Aleksei327/STM32G474-Precision-Lab-Power-Supply/hardware/jumper-wires.txt

WIRE JUMPERS - assembly list (single-sided board, top side)
Board POWER_0-50, 25 jumpers, total wire length ~1330 mm. Coordinates are KiCad board coordinates (mm).

N   NET          FROM (x,y) mm      TO (x,y) mm        LENGTH
------------------------------------------------------------------------
1   DVIN         ( 101.5, 103.2)   ( 189.0,  56.5)    99.2 mm
2   EN_LIN       ( 170.5, 122.2)   ( 174.5, 122.2)     4.1 mm
3   GND          ( 220.5,  90.2)   ( 193.5,  89.7)    27.0 mm
4   GND          ( 220.5, 146.2)   ( 194.5, 150.2)    26.3 mm
5   GND          (  88.0,  79.2)   (  67.9,  79.9)    20.2 mm
6   GND          ( 131.6, 120.3)   ( 118.9, 120.3)    12.8 mm
7   GND          (  66.2, 140.4)   (  55.5, 140.6)    10.7 mm
8   GND          ( 111.7,  54.1)   ( 113.7,  64.4)    10.5 mm
9   GND          ( 138.0,  90.2)   ( 135.5,  81.7)     8.9 mm
10  GND          ( 104.4,  82.7)   ( 104.5,  90.2)     7.5 mm
11  GND          (  92.5, 110.9)   (  97.5, 112.2)     5.1 mm
12  GND          (  92.5, 117.2)   (  92.5, 119.8)     2.5 mm
13  GND          ( 183.0, 131.2)   ( 185.5, 131.0)     2.5 mm
14  HI           ( 160.1,  99.2)   ( 161.1, 101.7)     2.6 mm
15  OUT_MINUS    ( 192.5, 131.0)   ( 107.0,  79.2)    99.9 mm
16  OUT_MINUS    ( 192.5, 131.0)   ( 244.5,  69.7)    80.4 mm
17  RELAY_DRV    ( 136.0,  88.2)   ( 242.3, 104.2)   107.5 mm
18  REV_DET      ( 119.0, 105.2)   ( 249.5,  46.1)   143.2 mm
19  V12          (  91.0,  54.6)   (  56.1,  68.5)    37.6 mm
20  VDS0         ( 100.0,  94.6)   ( 224.5,  65.2)   127.9 mm
21  VIN_55       ( 184.0,  84.2)   (  64.2, 152.7)   137.9 mm
22  VS0          ( 237.0,  85.2)   ( 105.5,  73.2)   132.0 mm
23  VT0          ( 252.5,  62.1)   ( 104.5, 105.7)   154.2 mm
24  V_N5         (  66.5,  39.7)   (  89.0,  49.6)    24.6 mm
25  V_P67        (  91.0,  57.2)   (  47.5,  47.0)    44.7 mm

By net: GND=11, OUT_MINUS=2, DVIN=1, EN_LIN=1, HI=1, RELAY_DRV=1, REV_DET=1, V12=1, VDS0=1, VIN_55=1, VS0=1, VT0=1, V_N5=1, V_P67=1
