Aleksei327/STM32G474-Precision-Lab-Power-Supply/docs/architecture.ru.md

# Архитектура системы

[English version](architecture.md) · [Обзор проекта](../README.ru.md) · [Полная схема](images/lab-psu-schematic-ru.svg)

## Назначение

Блок питания рассчитан на программируемый выход 0–50 В с пользовательским шагом 1 мВ и 1 мА и целевыми пульсациями не более 1 мВ. Высокий КПД и низкий шум совмещены разделением регулирования между импульсным предрегулятором и быстрым аналоговым пострегулятором.

Эти значения являются проектными целями. Аппаратура собрана и находится в наладке (ноябрь 2026); испытания под нагрузкой, тепловые испытания, коррекция петель и итоговая электрическая проверка ещё выполняются.

## Силовой тракт

```mermaid
flowchart LR
    A[Сеть 230 В] --> B[Активный PFC<br/>около 380 В DC]
    B --> C[Двухключевой forward<br/>гальваническая развязка]
    C --> D[Выпрямитель и фильтр<br/>около 55 В]
    D --> E[Синхронный buck<br/>трекинговый предрегулятор]
    E --> F[Демпфированный C-L-C-фильтр]
    F --> G[OPA454 + проходной MOSFET<br/>линейный пострегулятор]
    G --> H[Защиты и реле]
    H --> I[Выход 0-50 В]
```

### Изолированный сетевой преобразователь

Горячая часть использует силовые узлы доработанного ATX-блока NEO500 мощностью 500 Вт:

- активный PFC на CM6800TX и шина около 380 В;
- двухключевой прямоходовый преобразователь с первичными MOSFET 18N50;
- трансформатор управления затворами для синхронного верхнего и нижнего ключей;
- трансформаторная развязка сетевой части от выхода и управления;
- быстрый вторичный выпрямитель STTH30R03 и фильтр на 100 В.

Установленный трансформатор имеет вторичную обмотку 22 витка из четырёх параллельных проводов диаметром 0,6 мм. Для неё принят режим около 5–6 А длительно и 8 А кратковременно. Силовая часть рассчитана на последующую модернизацию трансформатора до 10 А.

### Трекинговый синхронный buck

Синхронный buck построен на двух IRFB4110 и драйвере UCC27211. Комплементарный ШИМ формирует HRTIM микроконтроллера STM32G474. Быстрые каналы АЦП измеряют напряжения на стоке и истоке линейного проходного MOSFET, а прошивка поддерживает на нём запас около 2–2,5 В.

Так основная мощность регулируется эффективным импульсным каскадом, а линейному каскаду остаётся достаточное напряжение для подавления пульсаций и переходных процессов.

Выход buck содержит:

- 1000 мкФ / 100 В и локальные керамические конденсаторы 4,7 мкФ / 100 В;
- последовательный дроссель 2,2 мкГн не менее 12 А;
- два керамических конденсатора 4,7 мкФ / 100 В у стока линейного каскада;
- электролит 100 мкФ / 100 В, ESR которого демпфирует резонанс C–L–C.

Частота среза фильтра около 10 кГц; на частоте коммутации примерно 95–100 кГц он даёт дополнительное подавление.

### Линейный пострегулятор

OPA454 сравнивает уставку ЦАП с масштабированным выходным напряжением и управляет проходным IRFB4110 по схеме истокового повторителя. В базовой сборке устанавливается один MOSFET; на плате предусмотрены места для дополнительных параллельных приборов, если это потребуется по результатам тепловых испытаний.

Делитель обратной связи около 110 кОм / 5,1 кОм задаёт усиление примерно 22. Применяются согласованные резисторы 0,1% и 25 ppm/°C, а остаточные погрешности коэффициента и смещения устраняются калибровкой.

Отрицательная шина −5 В выводит OPA454 из области ограничения нижнего размаха. Активная преднагрузка около 6 мА, привязанная к этой шине, удерживает аналоговую петлю в регулируемом состоянии около нуля и обеспечивает управляемое снижение напряжения.

## Уставки и измерение

| Функция | Реализация |
| --- | --- |
| Уставка напряжения | DAC8830, 16 бит, 0–2,5 В от REF5025 |
| Расчётная дискретность выхода | `2,5 В / 65536 × 22 ≈ 0,84 мВ` |
| Напряжение клемм и ток | 20-битный INA228 |
| Шунт тока | константан около 10 мОм с кельвиновским подключением |
| Дискретность измерения тока | около 31 мкА/LSB с выбранным шунтом |
| Регулирование тока | цифровой CC, целевая частота обновления около 1–2 кГц |
| Быстрые каналы трекинга | АЦП STM32, синхронизированные с HRTIM |

INA228 непосредственно измеряет напряжение выходной шины и ток шунта и не зависит от опоры АЦП микроконтроллера. Реле измерительного входа подключает VBUS к реальным клеммам при включённом силовом реле. Медленная цифровая коррекция компенсирует падения на реле, предохранителе, дорожках и шунте, не перенося быструю аналоговую петлю напряжения через переключающийся контакт.

## Режимы управления

- стабилизация напряжения быстрой аналоговой петлёй;
- цифровая стабилизация тока по данным INA228;
- программируемый foldback тока в зависимости от выходного напряжения;
- управляемый подъём и снижение напряжения;
- включение выхода после предварительных проверок;
- температурное снижение тока и отключение.

STM32G474 также обслуживает SPI-дисплей 480×320, раздельные энкодеры напряжения и тока, кнопку выхода, сброс аварии, вентилятор, USB DFU/CDC и звуковую сигнализацию.

## Система защит

Защиты разделены по требуемому времени реакции.

### Быстрый аппаратный тракт

Сигнал кельвиновского шунта усиливается OPAMP1 микроконтроллера и внешней дорожкой подаётся на COMP1. Порог компаратора задаёт внутренний ЦАП. При аварии аппаратный выход компаратора воздействует на HRTIM BRK и прекращает ШИМ buck без ожидания программного цикла. Одновременно прерывание записывает ноль во внешний DAC8830, закрывает линейный проходной элемент, защёлкивает аварию и подаёт команду на отключение выхода.

Отдельный компаратор перенапряжения использует тот же принцип остановки.

### Защиты выходного домена

- оптодатчик обратной полярности контролирует клеммы до замыкания реле;
- отдельный делитель напряжения клемм обнаруживает внешний положительный источник и залипшее реле;
- контроль шины около 55 В отслеживает обратную передачу энергии;
- однонаправленный TVS 1.5KE56A и антипараллельный силовой диод ограничивают выбросы на стороне регулятора;
- керамический предохранитель 15 А, 5×20 мм разрывает длительный аварийный ток;
- RC-снаббер уменьшает дугу при отключении индуктивной нагрузки;
- в штатном режиме выходное реле переключается только после снижения тока практически до нуля.

### Тепловая защита

NTC на радиаторе проходного элемента используется для управления вентилятором, foldback и программного отключения. Нормально замкнутый Klixon в цепи возврата катушки реле служит независимой аппаратной защитой от перегрева.

## Шины питания

- `5VSB` питает управляющую часть и модуль TFT.
- Модуль контроллера формирует 3,3 В цифровой логики.
- REF5025 питается от отфильтрованной `5VSB`.
- Высоковольтный buck MP9486 преобразует около 55 В в 12 В для драйвера, реле, вентилятора и вспомогательного преобразователя.
- Флайбэк на UC3845 формирует шины OPA454 около +67 В и −5 В. См. [Вспомогательный флайбэк](auxiliary-flyback.ru.md).

## Статус разработки

| Узел | Статус |
| --- | --- |
| Архитектура системы | определена |
| Электрическая схема текущей ревизии | завершена |
| Английские надписи на схеме | подготовлены |
| Разводка печатной платы | завершена, платы вытравлены и собраны |
| Прошивка | наладочная работает, рабочая в разработке |
| Коррекция петель и тепловая настройка | идёт наладка |
| Итоговая проверка точности, пульсаций, динамики и защит | ожидается |
