Aleksei327/STM32G474-Precision-Lab-Power-Supply/docs/auxiliary-flyback.ru.md

# Вспомогательный флайбэк +67 В / −5 В

[English version](auxiliary-flyback.md) · [Архитектура системы](architecture.ru.md) · [Полная схема](images/lab-psu-schematic-ru.svg)

## Назначение

Линейному регулятору OPA454 нужна верхняя шина выше максимального выходного напряжения и небольшая отрицательная шина для регулирования около нуля. Маломощный флайбэк на UC3845 формирует:

| Параметр | Расчётное значение |
| --- | --- |
| Вход | +12 В от преобразователя MP9486 |
| Положительный сырой выход | около +67 В, регулируемый, до 20 мА |
| Отрицательный сырой выход | около −5 В, кросс-регулируемый, до 15 мА |
| Выходная мощность | около 1,5 Вт с расчётным запасом до 2 Вт |
| Топология | неизолированный флайбэк в режиме прерывистого тока |
| Контроллер | токовый ШИМ-контроллер UC3845 |
| Частота коммутации | около 95 кГц |

Преобразователь имеет трансформаторную связь, но **не обеспечивает гальваническую развязку**: возвраты первичной и вторичной частей соединены с общей системной землёй.

## Частота контроллера

UC3845 ограничивает максимальный коэффициент заполнения примерно 50% и делит частоту генератора на два на выходе. При `Rt = 10 кОм` и `Ct = 910 пФ`:

```text
Fosc ≈ 1,72 / (Rt × Ct) ≈ 190 кГц
Fsw  ≈ Fosc / 2 ≈ 95 кГц
```

Деление на два — важное для этой схемы отличие UC3845 от UC3843.

## Трансформатор

Используется сердечник примерно EE16 от компактной люминесцентной лампы:

| Параметр | Значение |
| --- | --- |
| Центральный керн | около 4 × 5 мм, `Ae ≈ 20 мм²` |
| Зазор | около 0,4–0,6 мм |
| Ширина намотки | около 8 мм |
| Провод | около 0,25–0,30 мм |
| Первичная обмотка | 24 витка, один слой |
| Вторичная обмотка | непрерывная обмотка 181 виток с отводом: 13 витков для −5 В, затем 168 витков для +67 В |
| Расчётная индуктивность первичной обмотки | около 24–36 мкГн |
| Ограничение пикового тока | около 1,2 А |

### Порядок намотки и фазировка

1. Первичную обмотку 24 витка намотать внутренним слоем.
2. Наложить два слоя изоляции.
3. Начать вторичную обмотку с конца −5 В.
4. Намотать 13 витков и вывести отвод системной земли.
5. В том же направлении намотки продолжить ещё 168 витков до конца +67 В, изолируя слои.
6. Наложить внешнюю изоляцию.

Начало первичной обмотки подключается к `V12`, конец — к стоку MOSFET. Если обе обмотки намотаны в одном физическом направлении, конец вторичной обмотки со стороны каркаса, где находится начало первичной `V12`, является концом −5 В. Противоположный конец является +67 В.

## Силовой каскад

- внешний N-MOSFET CS630 на 200 В в корпусе DPAK/TO-252;
- токовый шунт `0,82 Ом`, 1 Вт между истоком и землёй;
- фильтр входа CS `1 кОм + 470 пФ`;
- затворный резистор `10 Ом` и подтяжка затвор–исток `10 кОм`;
- выпрямитель UF4005 на обмотке +67 В;
- выпрямитель SS14 на обмотке −5 В;
- обязательный RCD-кламп на UF4005, `22 кОм` и `1 нФ`;
- локальная развязка входа 12 В: `22 мкФ + 100 нФ`.

Ожидаемое напряжение на закрытом MOSFET ниже 50 В с учётом расчётного выброса, поэтому прибор на 200 В имеет большой запас. RCD-кламп всё равно обязателен: реальная амплитуда выброса определяется индуктивностью рассеяния трансформатора и разводкой.

## Обратная связь и фильтрация

Сырой выход +67 В регулируется непосредственно:

```text
Vout ≈ 2,5 В × (1 + 130 кОм / 5,1 кОм) ≈ 66 В
```

Шина −5 В определяется отношением витков и не требует высокой точности для питания OPA454.

После выпрямителей обе шины фильтруются:

```text
V_P67R ── 47 Ом ── V_P67
                      │
                   4,7 мкФ

V_N5R  ── 47 Ом ── V_N5
                      │
                   4,7 мкФ
```

Частота среза RC-фильтра около 700 Гц, что даёт примерно 42 дБ подавления на 95 кГц. Делитель обратной связи UC3845 подключён к `V_P67R` до фильтра, поэтому его дополнительный полюс не входит в контур регулирования. OPA454 и резисторы преднагрузки подключаются к чистым сторонам `V_P67` и `V_N5`.

## Проверка при первом запуске

Первичную проверку следует проводить от источника 8–12 В с ограничением тока, без включения полной сетевой части.

1. Убедиться, что выход +67 В положительный, а −5 В отрицательный.
2. Если обе полярности зеркальны, поменять местами внешние концы вторичной обмотки, не изменяя отвод земли.
3. Если оба выхода близки к нулю, а трансформатор или MOSFET быстро греется, поменять местами выводы первичной обмотки.
4. Измерить пиковый ток первичной обмотки и подтвердить значение ниже примерно 1,2 А.
5. Проверить форму напряжения на стоке MOSFET и уровень ограничения RCD-клампа.
6. Проверить регулирование и устойчивость на холостом ходу и при максимальной вспомогательной нагрузке.
7. Проверить чистые шины после фильтров 47 Ом / 4,7 мкФ до подключения OPA454.

Все окончательные параметры петли и расчётные допущения трансформатора должны быть подтверждены на собранной плате.
