Aleksei327/STM32G474-Precision-Lab-Power-Supply/hardware/POWER_0-50.kicad_pcb

## KiCad design hardware/POWER_0-50.kicad_pcb (2026-08-06)

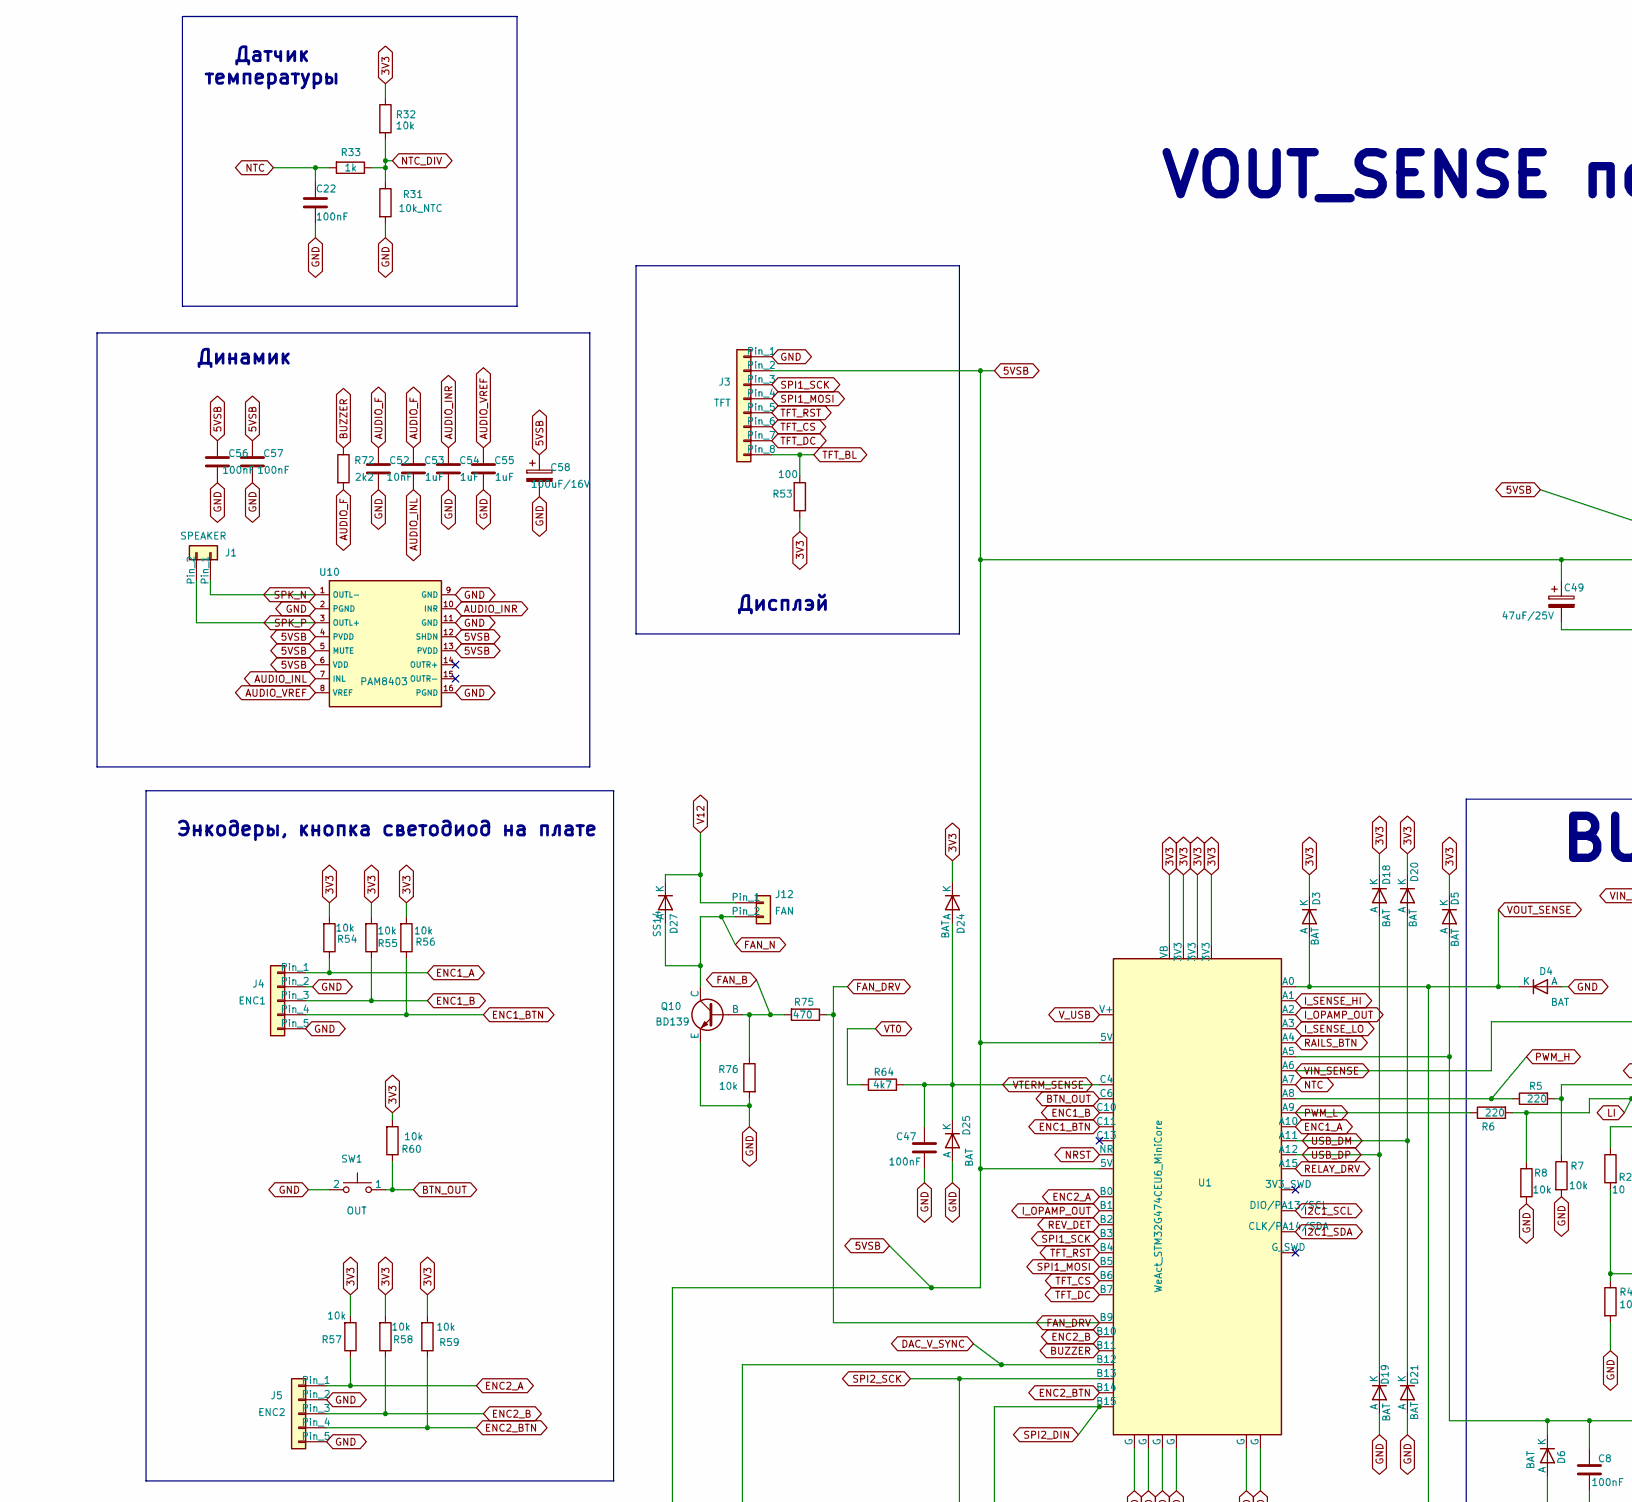
[picture p7: schematic POWER_0-50.kicad_sch, part in row 1, column 1]

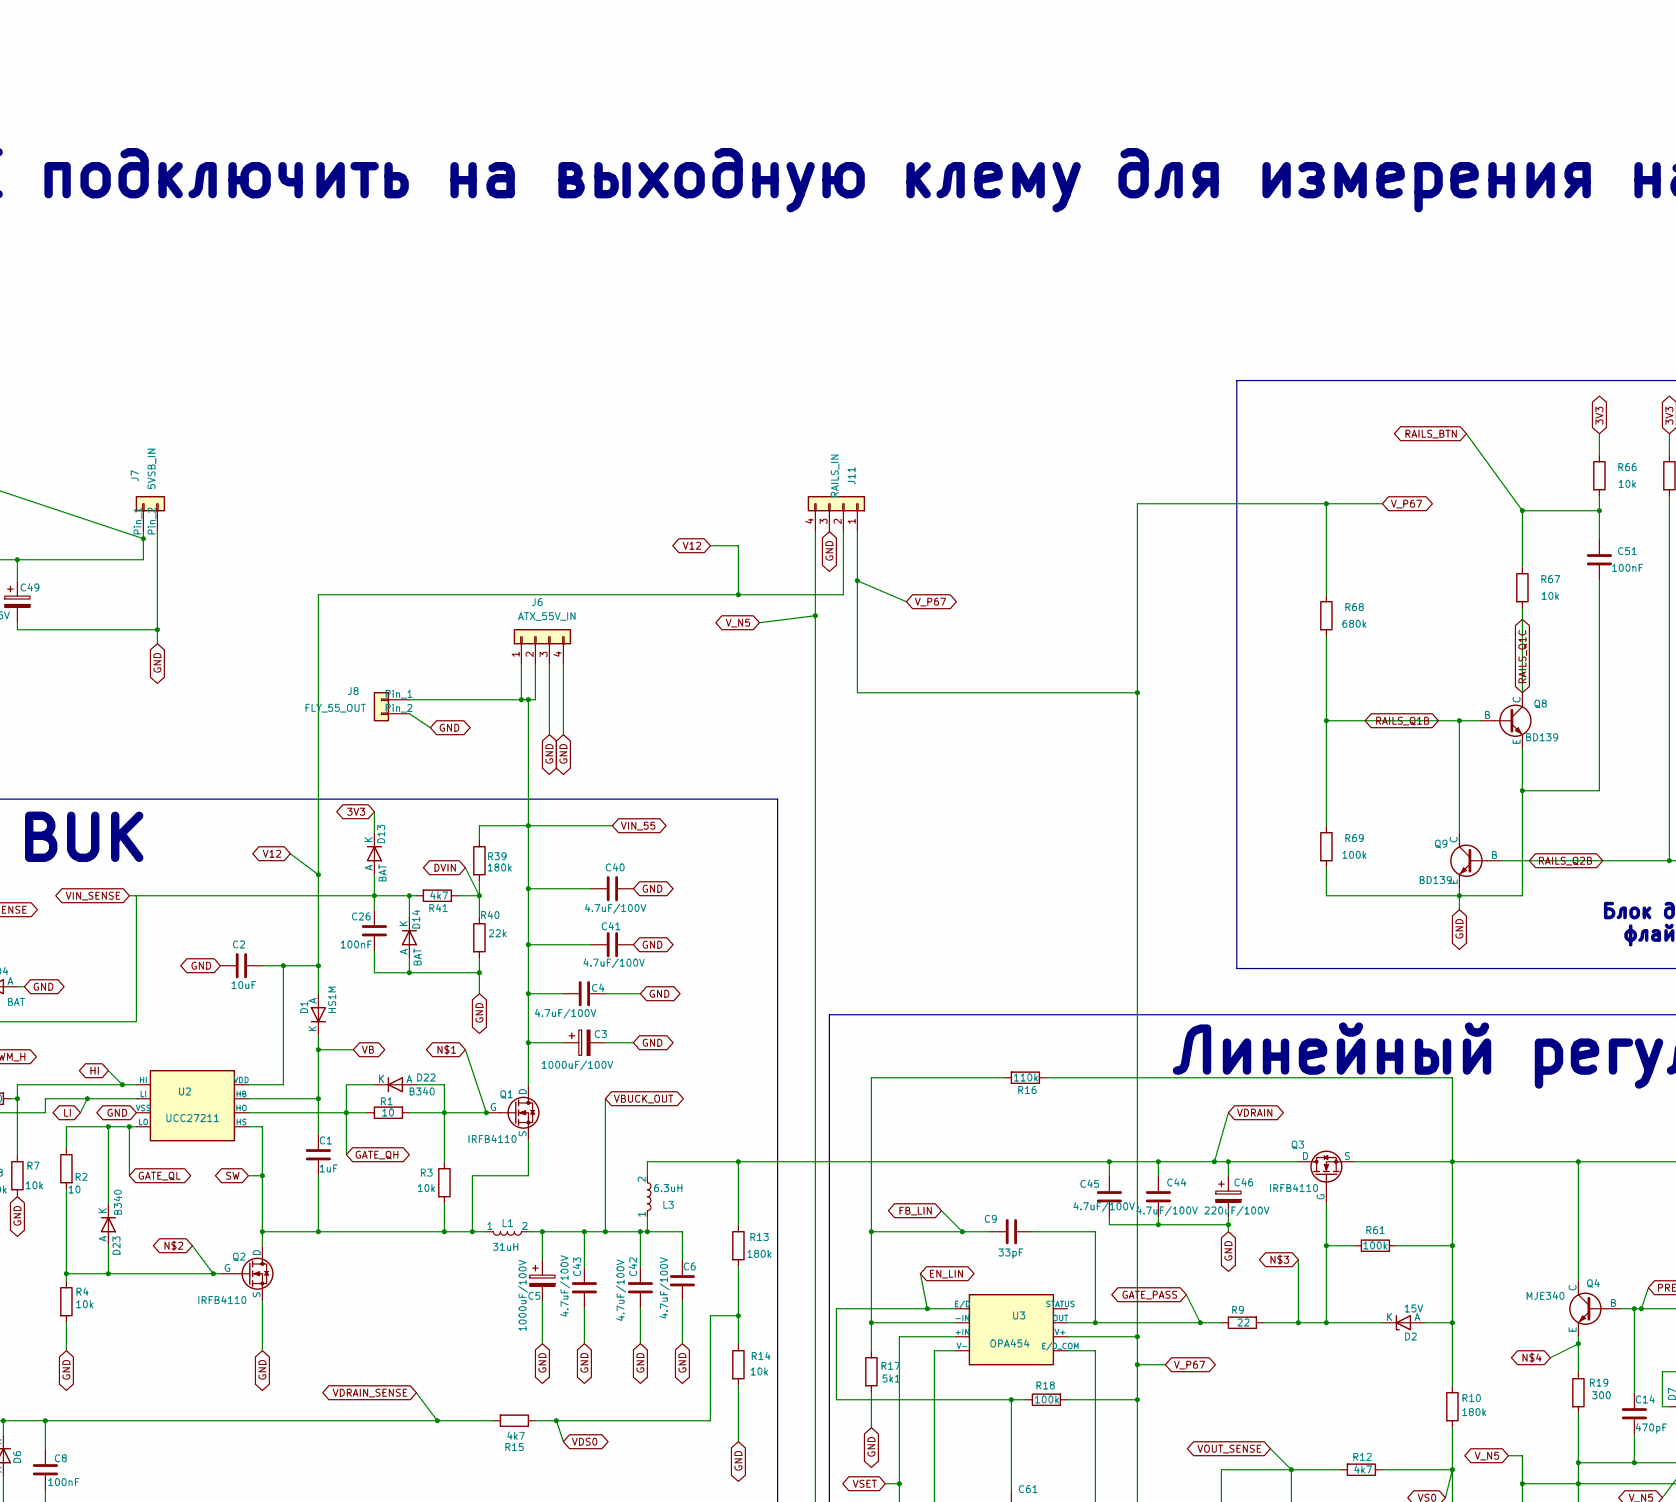
[picture p8: schematic POWER_0-50.kicad_sch, part in row 1, column 2]

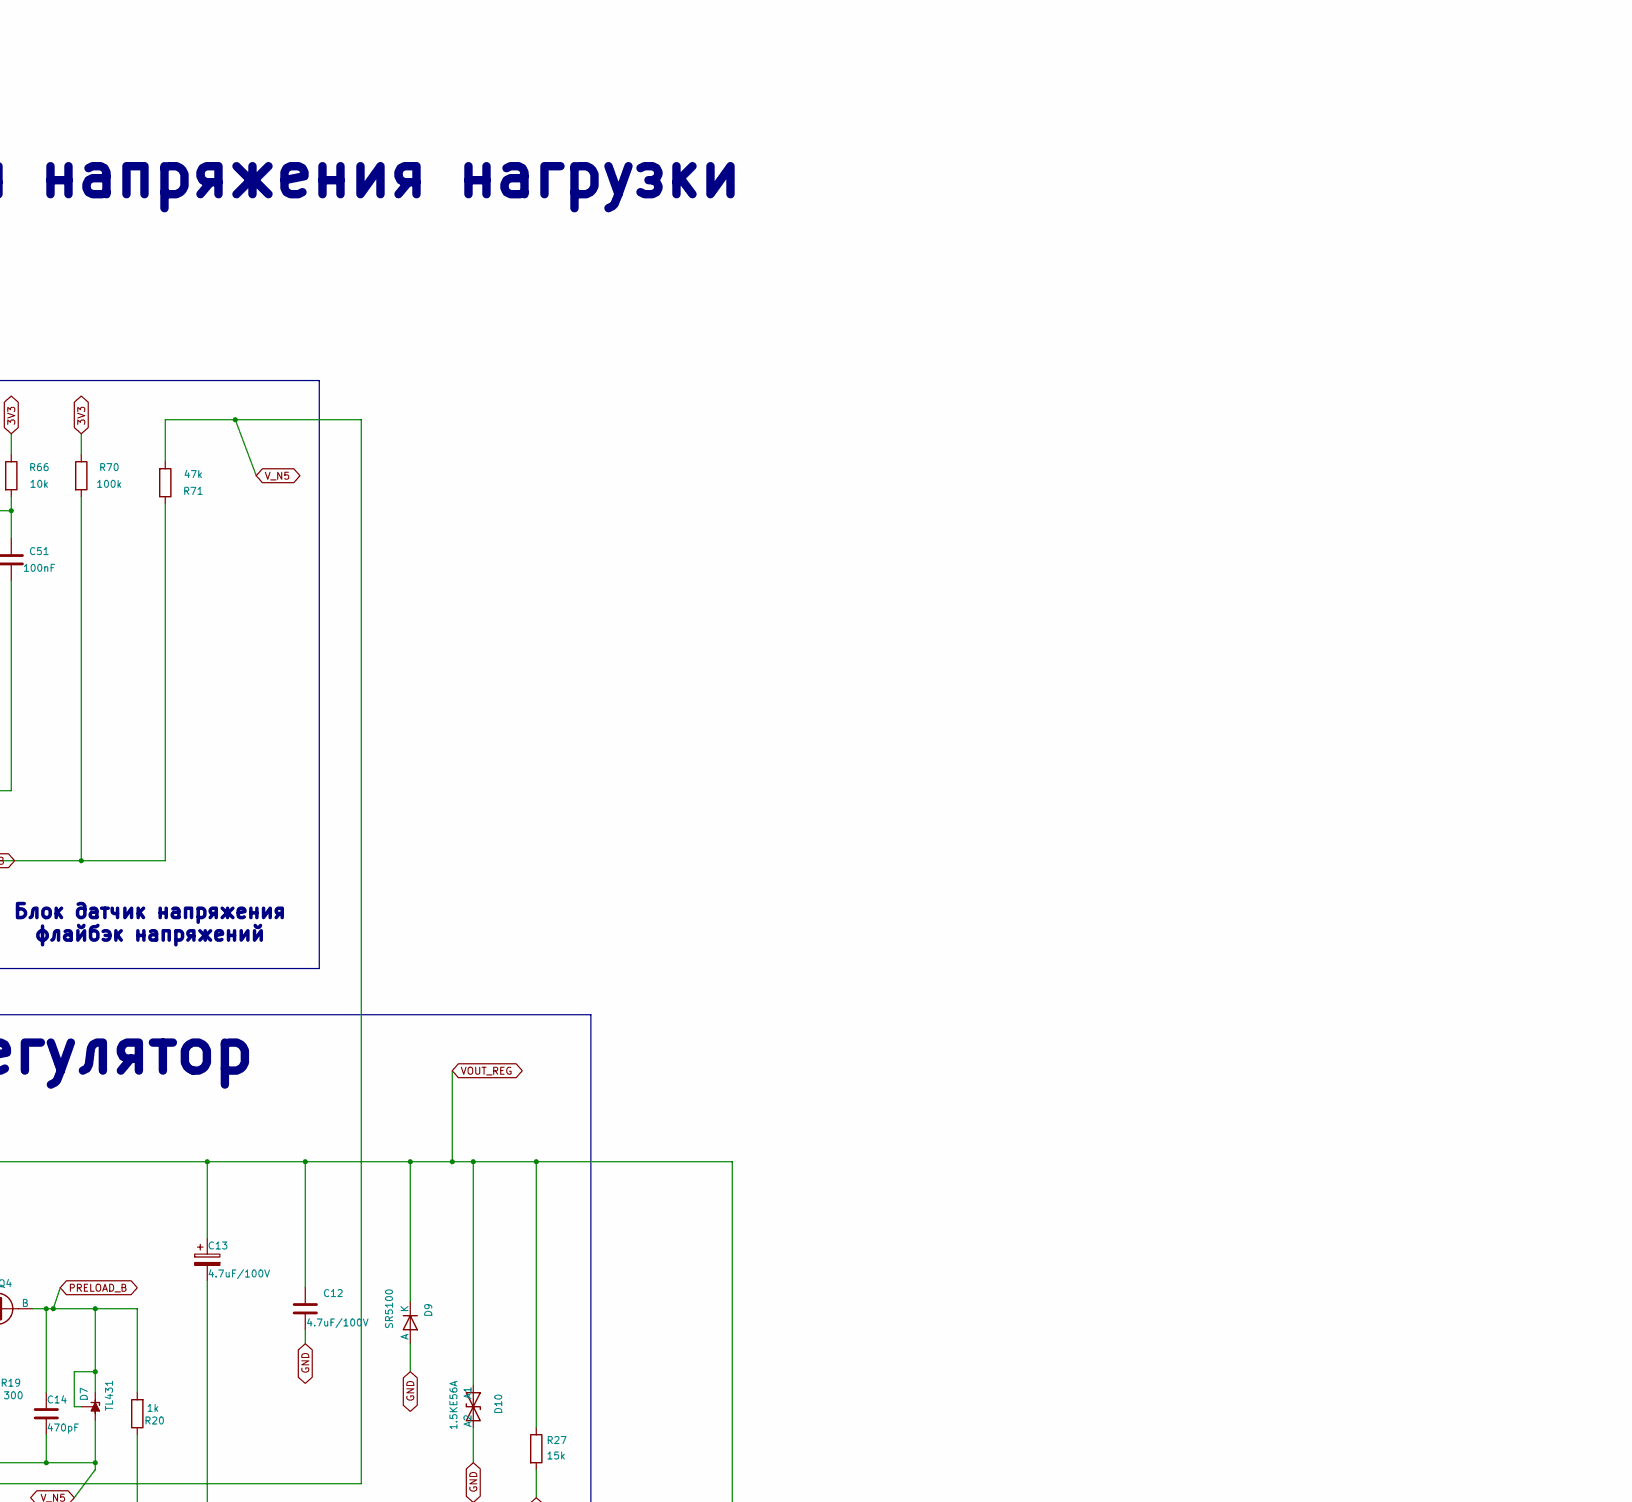
[picture p9: schematic POWER_0-50.kicad_sch, part in row 1, column 3]

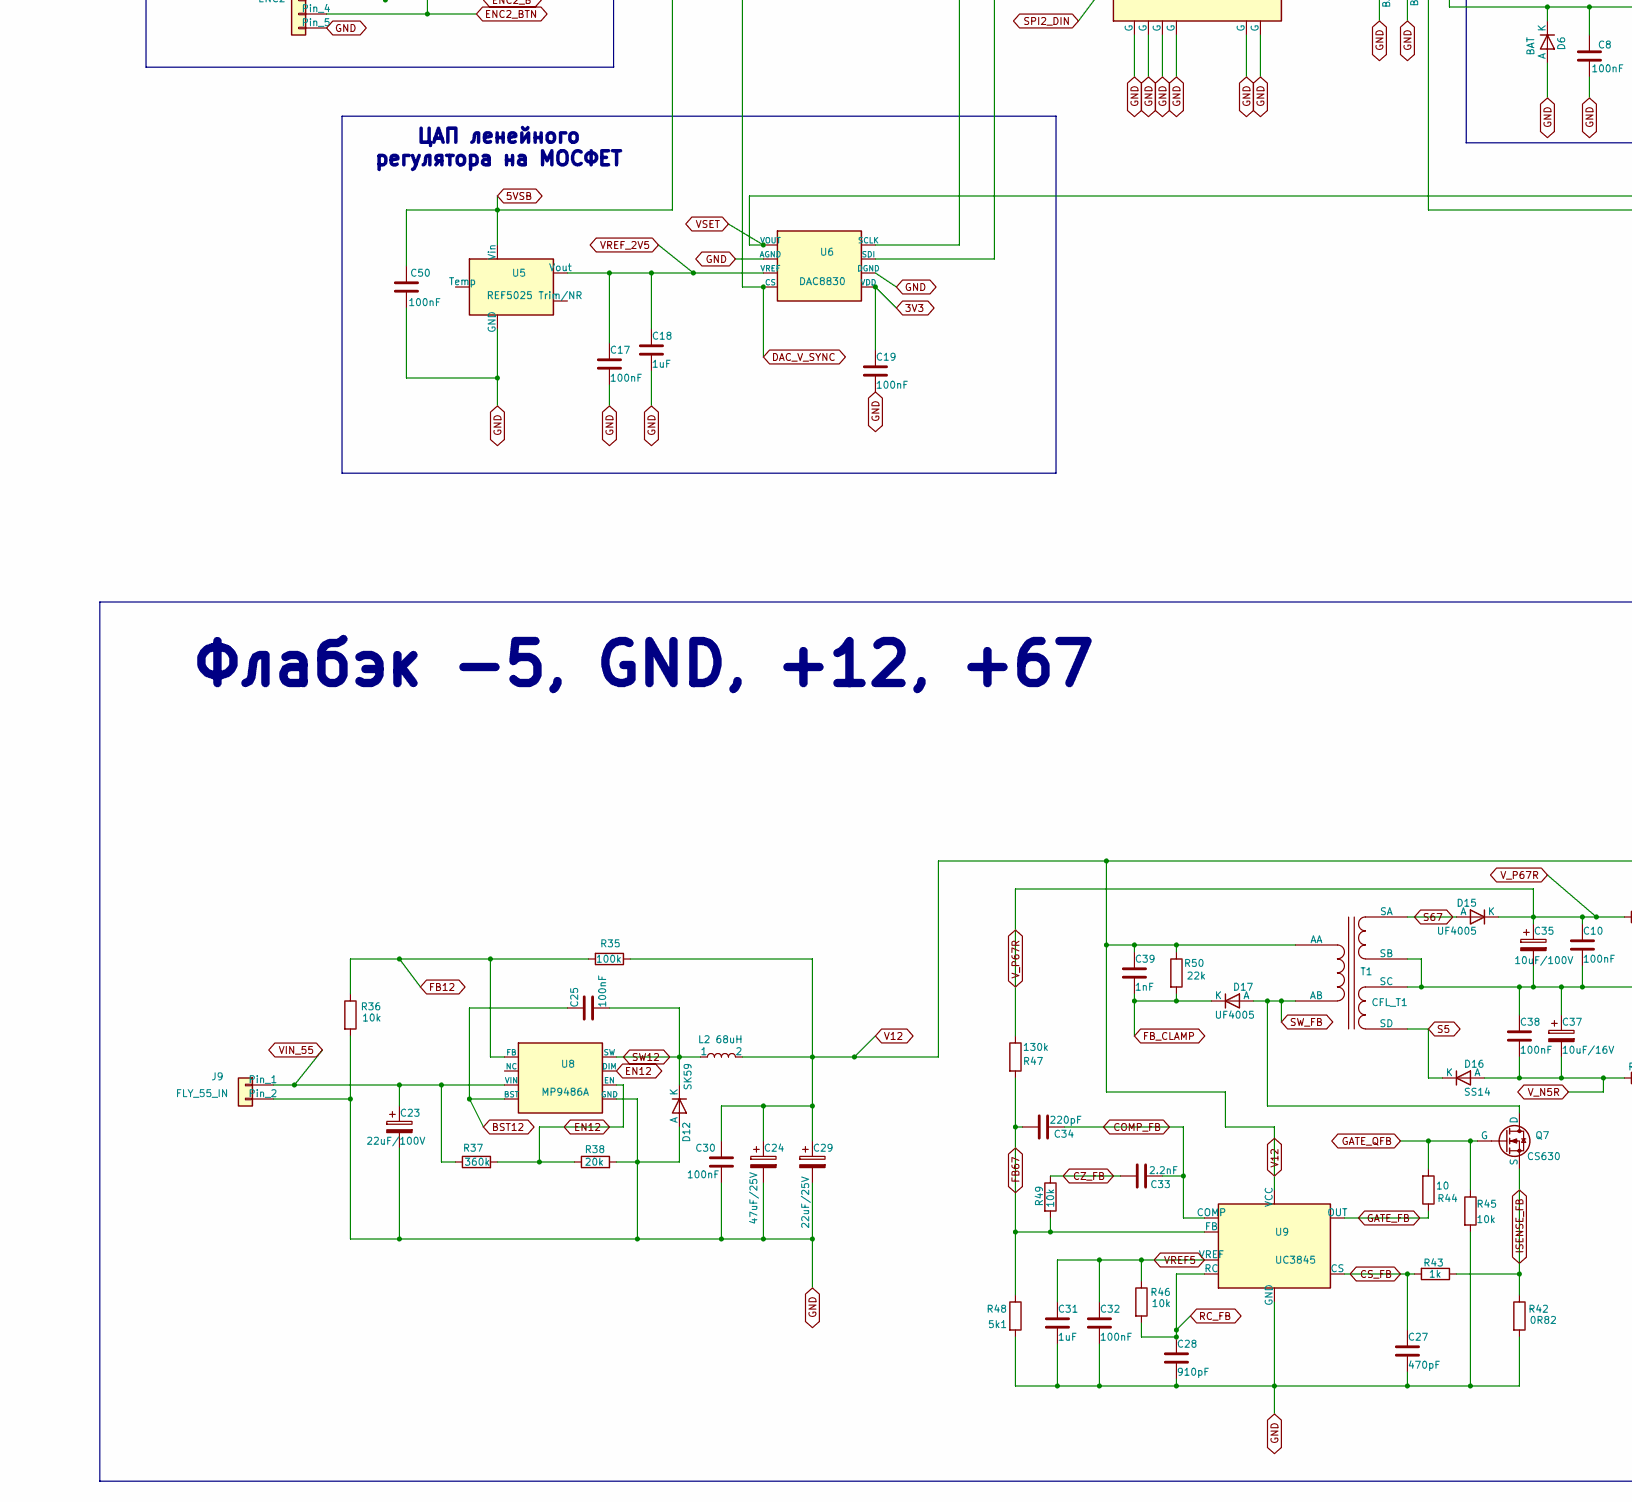
[picture p10: schematic POWER_0-50.kicad_sch, part in row 2, column 1]

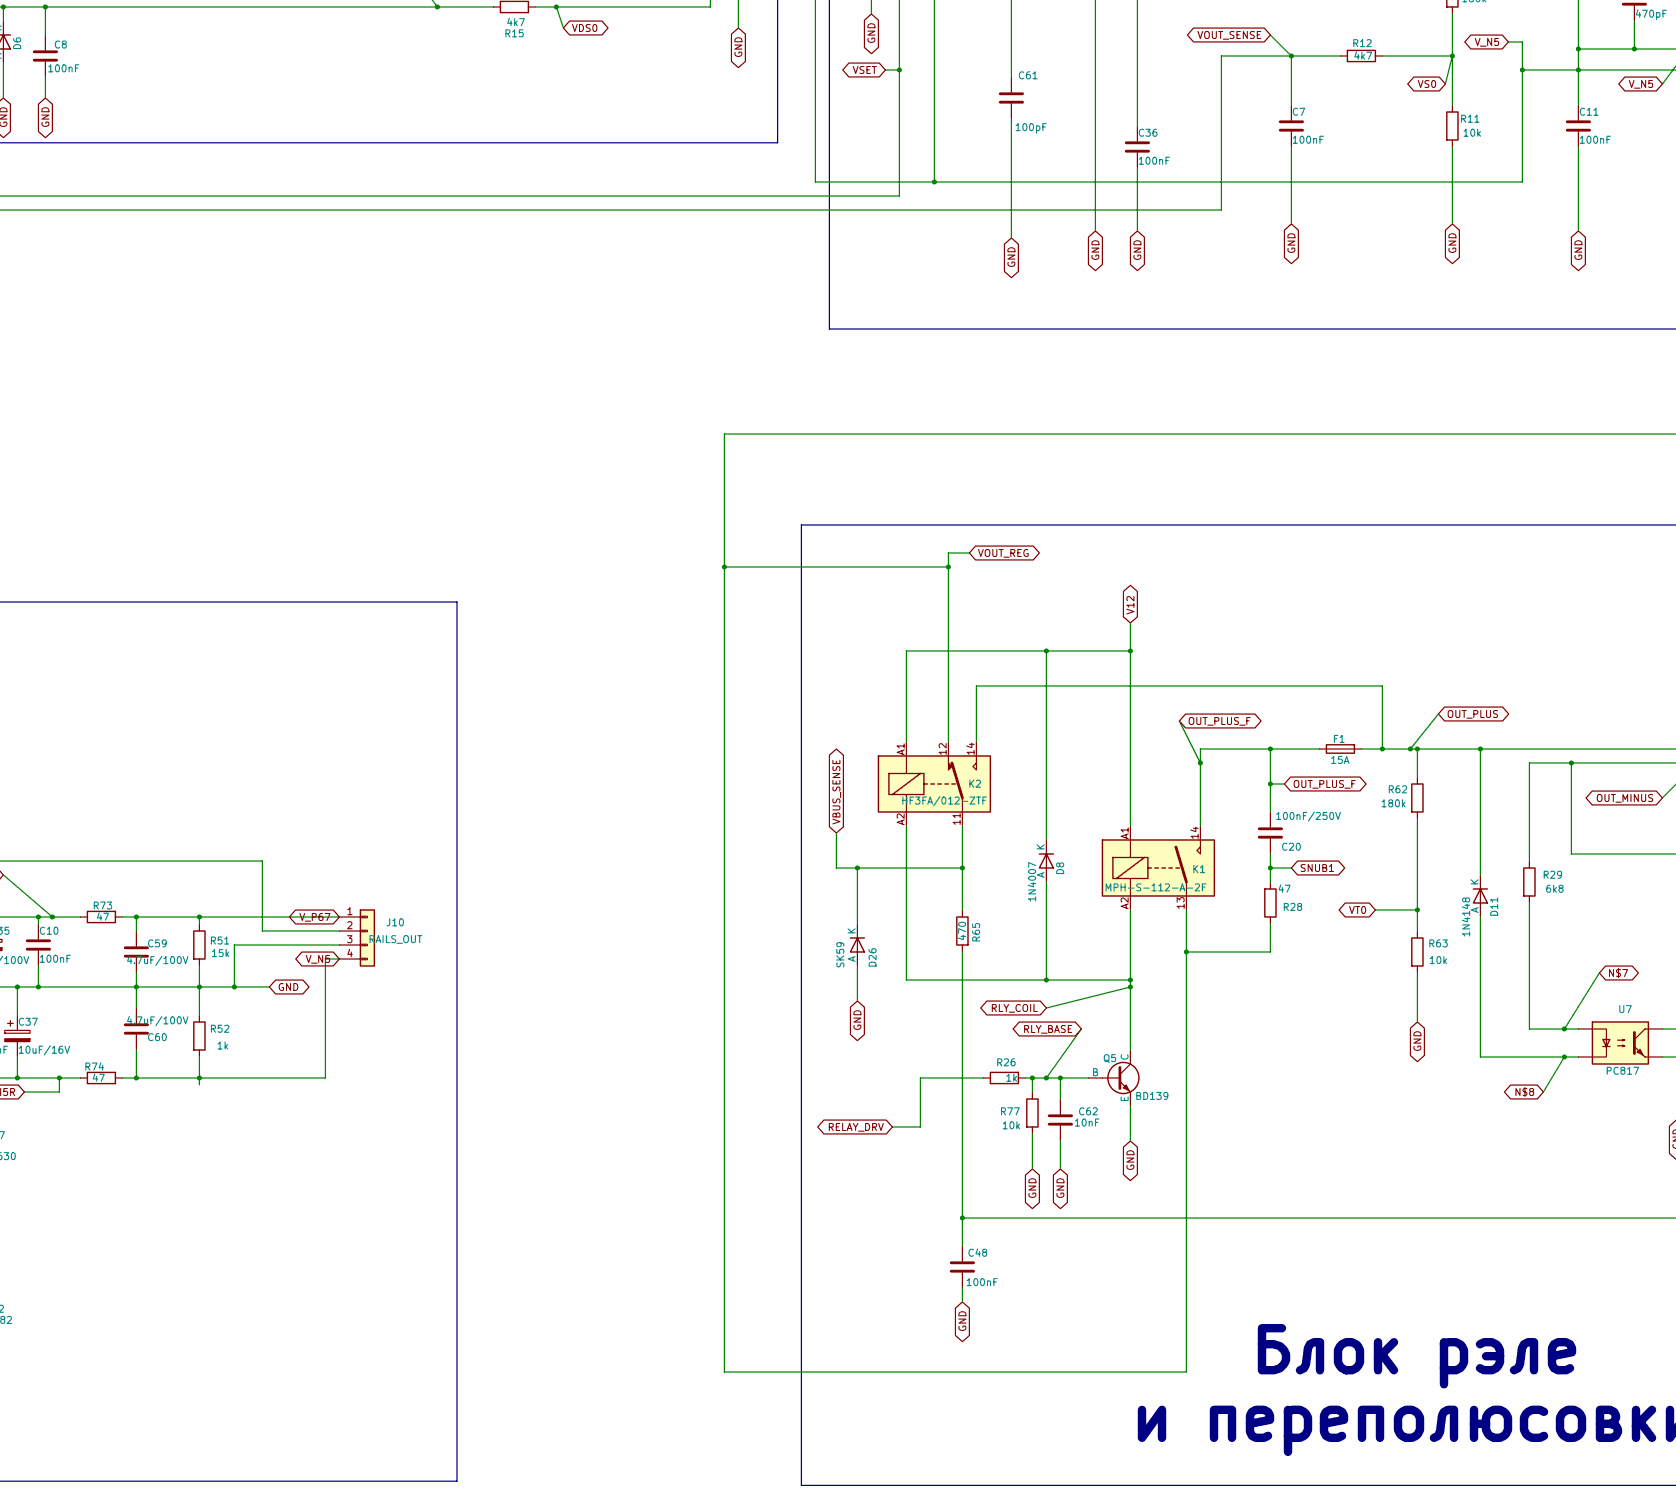
[picture p11: schematic POWER_0-50.kicad_sch, part in row 2, column 2]

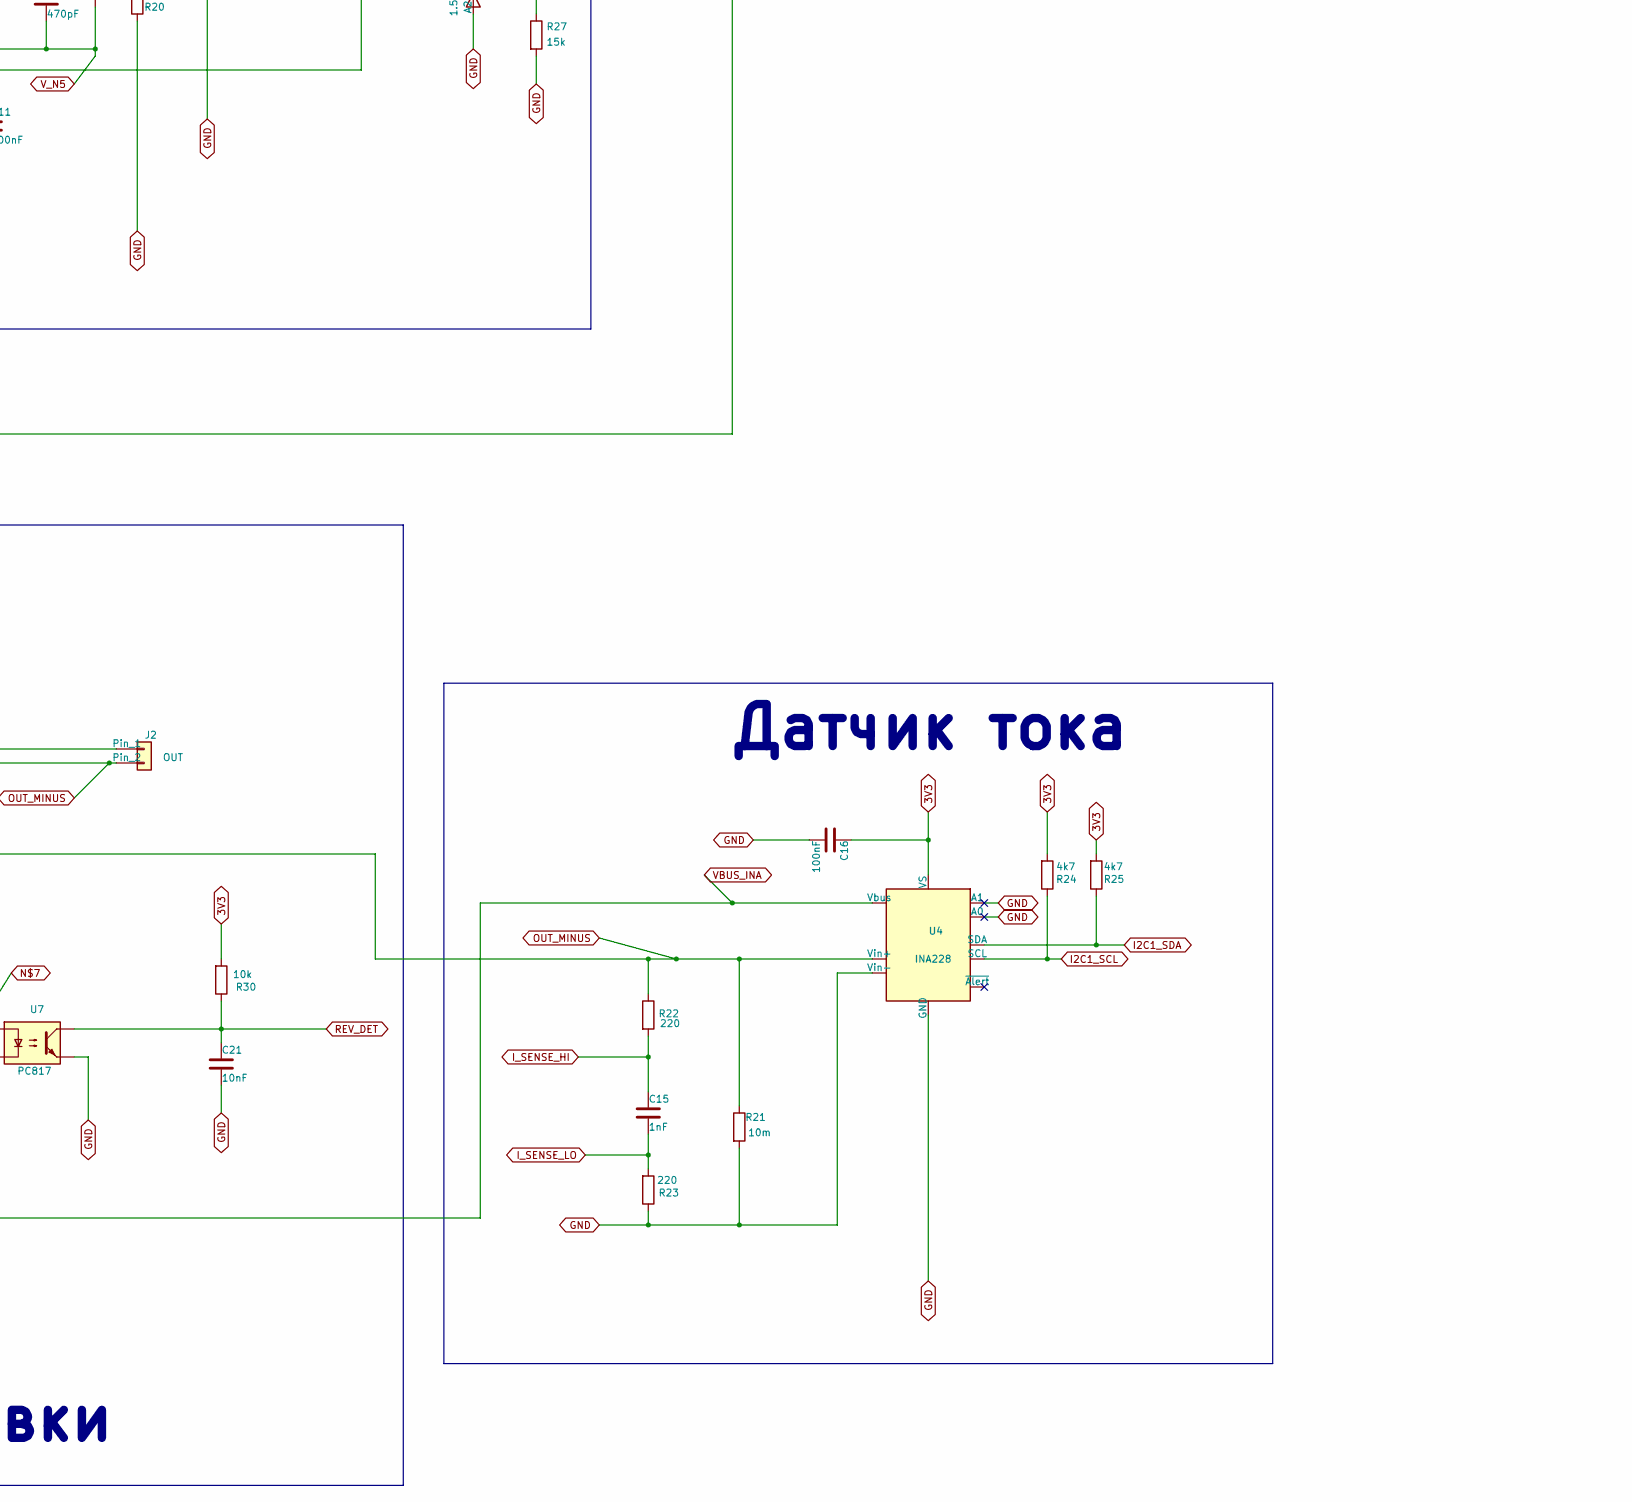
[picture p12: schematic POWER_0-50.kicad_sch, part in row 2, column 3]

Parts:
C1, C18, C31, C53, C54, C55: 1uF; C_1206_3216Metric
C2: 10uF; C_1206_3216Metric
C3, C5: 1000uF/100V; CP_Radial_D18.0mm_P7.50mm
C4, C6, C12, C13, C40, C41, C42, C43, C44, C45, C59, C60: 4.7uF/100V; C_1206_3216Metric
C7, C8, C10, C11, C16, C17, C19, C22, C25, C26, C30, C32, C36, C38, C47, C48, C50, C51, C56, C57: 100nF; C_1206_3216Metric
C9: 33pF; C_1206_3216Metric
C14, C27: 470pF; C_1206_3216Metric
C15, C39: 1nF; C_1206_3216Metric
C20: 100nF/250V; C_1206_3216Metric
C21, C52, C62: 10nF; C_1206_3216Metric
C23: 22uF/100V; CP_Radial_D10.0mm_P5.00mm
C24, C49: 47uF/25V; CP_Radial_D10.0mm_P5.00mm
C28: 910pF; C_1206_3216Metric
C29: 22uF/25V; CP_Radial_D10.0mm_P5.00mm
C33: 2.2nF; C_1206_3216Metric
C34: 220pF; C_1206_3216Metric
C35: 10uF/100V; CP_Radial_D10.0mm_P5.00mm
C37: 10uF/16V; CP_Radial_D10.0mm_P5.00mm
C46: 220uF/100V; CP_Radial_D13.0mm_P5.00mm
C58: 100uF/16V; CP_Radial_D10.0mm_P5.00mm
C61: 100pF; C_1206_3216Metric
D1: HS1M; D_SMA
D2: 15V; D_DO-35_SOD27_P10.16mm_Horizontal
D3, D4, D5, D6, D13, D14, D18, D19, D20, D21, D24, D25: BAT; D_SOD-323_HandSolder
D7: TL431; TO-126-3_Vertical
D8: 1N4007; D_DO-201AD_P15.24mm_Horizontal
D9: SR5100; D_DO-201AD_P15.24mm_Horizontal
D10: 1.5KE56A; D_DO-201AD_P15.24mm_Horizontal
D11: 1N4148; D_DO-35_SOD27_P10.16mm_Horizontal
D12, D26: SK59; D_SMC
D15, D17: UF4005; D_DO-41_SOD81_P10.16mm_Horizontal
D16, D27: SS14; D_SMA
D22, D23: B340; D_SMC
F1: 15A; Fuseholder_Clip-5x20mm_Littelfuse_100_Inline_P20.50x4.60mm_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
J1: SPEAKER; PinHeader_1x02_P2.54mm_Vertical
J2: OUT; TerminalBlock_MaiXu_MX126-5.0-02P_1x02_P5.00mm
J3: TFT; PinHeader_1x08_P2.54mm_Vertical
J4: ENC1; PinHeader_1x05_P2.54mm_Vertical
J5: ENC2; PinHeader_1x05_P2.54mm_Vertical
J6: ATX_55V_IN; Molex_KK-396_A-41791-0004_1x04_P3.96mm_Vertical
J7: 5VSB_IN; PinHeader_1x02_P2.54mm_Vertical
J8: FLY_55_OUT; PinHeader_1x02_P2.54mm_Vertical
J9: FLY_55_IN; Conn_FLY55_JST_EH_1x03_P2.5_pins13
J10: RAILS_OUT; Conn_RAILS_1x04_P2.54_D0.6
J11: RAILS_IN; PinSocket_1x04_P2.54mm_Vertical
J12: FAN; PinHeader_1x02_P2.54mm_Vertical
K1: MPH-S-112-A-2F; Relay_MPH_1A
K2: HF3FA/012-ZTF; Relay_HF3FA_1C
L1: 31uH; L_Toroid_Vertical_Core25x10mm_P14.00mm_D1.8mm
L2: 68uH; L_SMD_15x15mm
L3: 6.3uH; L_Toroid_Vertical_Core21x7mm_P10.00mm_D2.0mm
Q1, Q2, Q3: IRFB4110; TO-220-3_Vertical
Q4: MJE340; TO-126-3_Vertical
Q5, Q8, Q9, Q10: BD139; TO-126-3_Vertical
Q7: CS630; TO-252-2
R1, R2: 10; R_2512_6332Metric
R3, R4, R7, R8, R11, R14, R30, R32, R36, R45, R46, R49, R54, R55, R56, R57, R58, R59, R60, R63, R66, R67, R76, R77: 10k; R_1206_3216Metric
R5, R6, R22, R23: 220; R_1206_3216Metric
R9: 22; R_Axial_DIN0207_L6.3mm_D2.5mm_P10.16mm_Horizontal
R10, R13, R39, R62: 180k; R_1206_3216Metric
R12, R15, R24, R25, R41, R64: 4k7; R_1206_3216Metric
R16: 110k; R_0805_2012Metric
R17: 5k1; R_0805_2012Metric
R18, R35, R61, R69, R70: 100k; R_1206_3216Metric
R19: 300; R_1206_3216Metric
R20, R26, R33, R43, R52: 1k; R_1206_3216Metric
R21: 10m; Shunt_Constantan_Staple_P20mm
R27, R51: 15k; R_Axial_DIN0207_L6.3mm_D2.5mm_P10.16mm_Horizontal
R28: 47; R_Axial_DIN0207_L6.3mm_D2.5mm_P10.16mm_Horizontal
R29: 6k8; R_Axial_DIN0207_L6.3mm_D2.5mm_P10.16mm_Horizontal
R31: 10k_NTC; NTC_THT_P7.00mm_Pad2.0mm_D0.6mm
R37: 360k; R_1206_3216Metric
R38: 20k; R_1206_3216Metric
R40, R50: 22k; R_1206_3216Metric
R42: 0R82; R_Axial_DIN0411_L9.9mm_D3.6mm_P12.70mm_Horizontal
R44: 10; R_1206_3216Metric
R47: 130k; R_1206_3216Metric
R48: 5k1; R_1206_3216Metric
R53: 100; R_1206_3216Metric
R65, R75: 470; R_1206_3216Metric
R68: 680k; R_1206_3216Metric
R71: 47k; R_1206_3216Metric
R72: 2k2; R_1206_3216Metric
R73, R74: 47; R_1206_3216Metric
SW1: OUT; PinHeader_1x02_P2.54mm_Vertical
T1: CFL_T1; Transformer_Flyback_EE16
U1: WeAct_STM32G474CEU6_MiniCore
U2: UCC27211; UCC27211_HSOP-8-1EP_HandSolder
U3: OPA454; OPA454_HSOP-8-1EP_HandSolder
U4: INA228; INA228_Module_1x08
U5: REF5025; SOIC-8_3.9x4.9mm_P1.27mm_Pad0.8mm
U6: DAC8830; SOIC-8_3.9x4.9mm_P1.27mm_Pad0.8mm
U7: PC817; DIP-4_W7.62mm
U8: MP9486A; MP9486A_HSOP-8-1EP_HandSolder
U9: UC3845; SOIC-8_3.9x4.9mm_P1.27mm_Pad0.8mm
U10: PAM8403; SOIC-16_3.9x9.9mm_P1.27mm_Pad0.8mm

Connections:
3V3: C16.1, C19.1, D3.1 (K), D5.1 (K), D13.1 (K), D18.1 (K), D20.1 (K), D24.1 (K), R24.2, R25.2, R30.2, R32.1, R53.1, R54.2, R55.2, R56.2, R57.2, R58.2, R59.2, R60.2, R66.1, R70.1, U1.3 (3V3), U1.4 (3V3), U1.22 (VB), U1.23 (3V3), U4.6 (VS), U6.8 (VDD)
5VSB: C49.1, C50.1, C56.1, C57.1, C58.1, J3.2, J7.1, U1.27 (5V), U1.28 (5V), U5.2 (Vin), U10.4 (PVDD), U10.5 (MUTE), U10.6 (VDD), U10.12 (SHDN), U10.13 (PVDD)
AUDIO_F: C52.1, C53.1, R72.2
AUDIO_INL: C53.2, U10.7 (INL)
AUDIO_INR: C54.1, U10.10 (INR)
AUDIO_VREF: C55.1, U10.8 (VREF)
BST12: C25.1, U8.4 (BST)
BTN_OUT: R60.1, SW1.1, U1.33 (C6)
BUZZER: R72.1, U1.5 (B11)
COMP_FB: C33.1, C34.1, U9.1 (COMP)
CS_FB: C27.1, R43.2, U9.3 (CS)
CZ_FB: C33.2, R49.1
DAC_V_SYNC: U1.29 (B12), U6.4 (CS)
DVIN: R39.2, R40.1, R41.1
EN12: R37.2, R38.1, U8.6 (DIM), U8.7 (EN)
ENC1_A: J4.1, R54.1, U1.36 (A10)
ENC1_B: J4.3, R55.1, U1.40 (C10)
ENC1_BTN: J4.4, R56.1, U1.41 (C11)
ENC2_A: J5.1, R57.1, U1.10 (B0)
ENC2_B: J5.3, R58.1, U1.6 (B10)
ENC2_BTN: J5.4, R59.1, U1.31 (B14)
EN_LIN: C61.1, R18.1, U3.8 (E/D)
FAN_B: Q10.3 (B), R75.2, R76.1
FAN_DRV: R75.1, U1.47 (B9)
FAN_N: D27.2 (A), J12.2, Q10.2 (C)
FB12: R35.2, R36.1, U8.1 (FB)
FB67: C34.2, R47.2, R48.1, R49.2, U9.2 (FB)
FB_CLAMP: C39.2, D17.1 (K), R50.2
FB_LIN: C9.2, R16.2, R17.1, U3.2 (-IN)
GATE_FB: R44.1, U9.6 (OUT)
GATE_PASS: C9.1, R9.1, U3.6 (OUT)
GATE_QFB: Q7.1 (G), R44.2, R45.1
GATE_QH: D22.1 (K), R1.1, U2.3 (HO)
GATE_QL: D23.1 (K), R2.1, U2.8 (LO)
GND: C2.2, C3.2, C4.2, C5.2, C6.2, C7.2, C8.2, C10.2, C11.2, C12.2, C13.2, C16.2, C17.2, C18.2, C19.2, C21.2, C22.2, C23.2, C24.2, C26.2, C27.2, C28.2, C29.2, C30.2, C31.2, C32.2, C35.2, C36.2, C37.1, C38.1, C40.2, C41.2, C42.2, C43.2, C44.2, C45.2, C46.2, C47.2, C48.2, C49.2, C50.2, C51.2, C52.2, C54.2, C55.2, C56.2, C57.2, C58.2, C59.2, C60.2, C61.2, C62.2, D4.2 (A), D6.2 (A), D9.2 (A), D10.2 (A2), D12.2 (A), D14.2 (A), D19.2 (A), D21.2 (A), D25.2 (A), D26.2 (A), J3.1, J4.2, J4.5, J5.2, J5.5, J6.3, J6.4, J7.2, J8.2, J9.2, J10.3, J11.3, Q2.3 (S), Q5.1 (E), Q8.1 (E), Q9.1 (E), Q10.1 (E), R4.2, R7.2, R8.2, R11.2, R14.2, R17.2, R20.1, R21.2, R23.1, R27.2, R31.2, R36.2, R38.2, R40.2, R42.2, R45.2, R48.2, R51.2, R52.1, R63.2, R69.2, R76.2, R77.2, SW1.2, T1.4 (SC), U1.1 (G), U1.2 (G), U1.24 (G), U1.25 (G), U1.26 (G), U1.48 (G), U2.7 (VSS), U3.1 (E/D_COM), U4.1 (A1), U4.2 (A0), U4.7 (GND), U4.9 (Vin-), U5.4 (GND), U6.2 (AGND), U6.7 (DGND), U7.3, U8.8 (GND), U9.5 (GND), U10.2 (PGND), U10.9 (GND), U10.11 (GND), U10.16 (PGND)
HI: R5.2, R7.1, U2.5 (HI)
I2C1_SCL: R24.1, U1.DIO (DIO/PA13/SCL), U4.5 (SCL)
I2C1_SDA: R25.1, U1.CLK (CLK/PA14/SDA), U4.4 (SDA)
ISENSE_FB: Q7.3 (S), R42.1, R43.1
I_OPAMP_OUT: U1.9 (B1), U1.17 (A2)
I_SENSE_HI: C15.1, R22.2, U1.18 (A1)
I_SENSE_LO: C15.2, R23.2, U1.16 (A3)
LI: R6.2, R8.1, U2.6 (LI)
unnamed: D22.2 (A), Q1.1 (G), R1.2, R3.1
unnamed: D23.2 (A), Q2.1 (G), R2.2, R4.1
unnamed: D2.1 (K), Q3.1 (G), R9.2, R61.1
unnamed: Q4.1 (E), R19.1
unnamed: R29.2, U7.1
unnamed: D11.2 (A), U7.2
NRST: U1.20 (NR)
NTC: C22.1, R33.2, U1.12 (A7)
NTC_DIV: R31.1, R32.2, R33.1
OUT_MINUS: J2.2, R21.1, R22.1, R29.1, U4.10 (Vin+)
OUT_PLUS: D11.1 (K), F1.2, J2.1, K2.14, R62.1
OUT_PLUS_F: C20.2, F1.1, K1.14
PRELOAD_B: C14.1, D7.1 (REF), D7.3 (K), Q4.3 (B), R20.2
PWM_H: R5.1, U1.34 (A8)
PWM_L: R6.1, U1.35 (A9)
RAILS_BTN: C51.1, R66.2, R67.1, U1.15 (A4)
RAILS_Q1B: Q8.3 (B), Q9.2 (C), R68.2, R69.1
RAILS_Q1C: Q8.2 (C), R67.2
RAILS_Q2B: Q9.3 (B), R70.2, R71.1
RC_FB: C28.1, R46.2, U9.4 (RC)
RELAY_DRV: R26.1, U1.39 (A15)
REV_DET: C21.1, R30.1, U1.8 (B2), U7.4
RLY_BASE: C62.1, Q5.3 (B), R26.2, R77.1
RLY_COIL: D8.2 (A), K1.A2, K2.A2, Q5.2 (C)
S5: D16.1 (K), T1.3 (SD)
S67: D15.2 (A), T1.5 (SA)
SNUB1: C20.1, R28.2
SPI1_MOSI: J3.4, U1.44 (B5)
SPI1_SCK: J3.3, U1.42 (B3)
SPI2_DIN: U1.32 (B15), U6.6 (SDI)
SPI2_SCK: U1.30 (B13), U6.5 (SCLK)
SPK_N: J1.1, U10.1 (OUTL-)
SPK_P: J1.2, U10.3 (OUTL+)
SW: C1.2, L1.1, Q1.3 (S), Q2.2 (D), R3.2, U2.4 (HS)
SW12: C25.2, D12.1 (K), L2.1, U8.5 (SW)
SW_FB: D17.2 (A), Q7.2 (D), T1.2 (AB)
TFT_BL: J3.8, R53.2
TFT_CS: J3.6, U1.45 (B6)
TFT_DC: J3.7, U1.46 (B7)
TFT_RST: J3.5, U1.43 (B4)
USB_DM: D20.2 (A), D21.1 (K), U1.37 (A11)
USB_DP: D18.2 (A), D19.1 (K), U1.38 (A12)
V12: C2.1, C24.1, C29.1, C30.1, C39.1, D1.2 (A), D8.1 (K), D27.1 (K), J10.2, J11.2, J12.1, K1.A1, K2.A1, L2.2, R35.1, R50.1, T1.1 (AA), U2.1 (VDD), U9.7 (VCC)
VB: C1.1, D1.1 (K), U2.2 (HB)
VBUCK_OUT: C5.1, C6.1, C42.1, C43.1, L1.2, L3.1
VBUS_INA: C48.1, R65.2, U4.8 (Vbus)
VBUS_SENSE: D26.1 (K), K2.11, R65.1
VDRAIN: C44.1, C45.1, C46.1, L3.2, Q3.2 (D), R13.1
VDRAIN_SENSE: C8.1, D5.2 (A), D6.1 (K), R15.2, U1.14 (A5)
VDS0: R13.2, R14.1, R15.1
VIN_55: C3.1, C4.1, C23.1, C40.1, C41.1, J6.1, J6.2, J8.1, J9.1 (Pin_1_1), Q1.2 (D), R37.1, R39.1, U8.3 (VIN)
VIN_SENSE: C26.1, D13.2 (A), D14.1 (K), R41.2, U1.13 (A6)
VOUT_REG: C12.1, C13.1, D2.2 (A), D9.1 (K), D10.1 (A1), K1.13, K2.12, Q3.3 (S), Q4.2 (C), R10.1, R16.1, R27.1, R28.1, R61.2
VOUT_SENSE: C7.1, D3.2 (A), D4.1 (K), R12.2, U1.19 (A0)
VREF5: C31.1, C32.1, R46.1, U9.8 (VREF)
VREF_2V5: C17.1, C18.1, U5.6 (Vout), U6.3 (VREF)
VS0: R10.2, R11.1, R12.1
VSET: U3.3 (+IN), U6.1 (VOUT)
VT0: R62.2, R63.1, R64.1
VTERM_SENSE: C47.1, D24.2 (A), D25.1 (K), R64.2, U1.11 (C4)
V_N5: C11.1, C14.2, C60.1, D7.2 (A), J10.4, J11.4, R19.2, R52.2, R71.2, R74.2, U3.4 (V-)
V_N5R: C37.2, C38.2, D16.2 (A), R74.1
V_P67: C36.1, C59.1, J10.1, J11.1, R18.2, R51.1, R68.1, R73.2, U3.7 (V+)
V_P67R: C10.1, C35.1, D15.1 (K), R47.1, R73.1
V_USB: U1.7 (V+)

Notes on the sheet:
VOUT_SENSE подключить на выходную клему для измерения напряжения нагрузки
Динамик
Флабэк -5, GND, +12, +67
Блок датчик напряжения флайбэк напряжений
Датчик температуры
Дисплэй
Линейный регулятор
ЦАП ленейного регулятора на МОСФЕТ
Блок рэле и переполюсовки
Датчик тока
BUK
Энкодеры, кнопка светодиод на плате

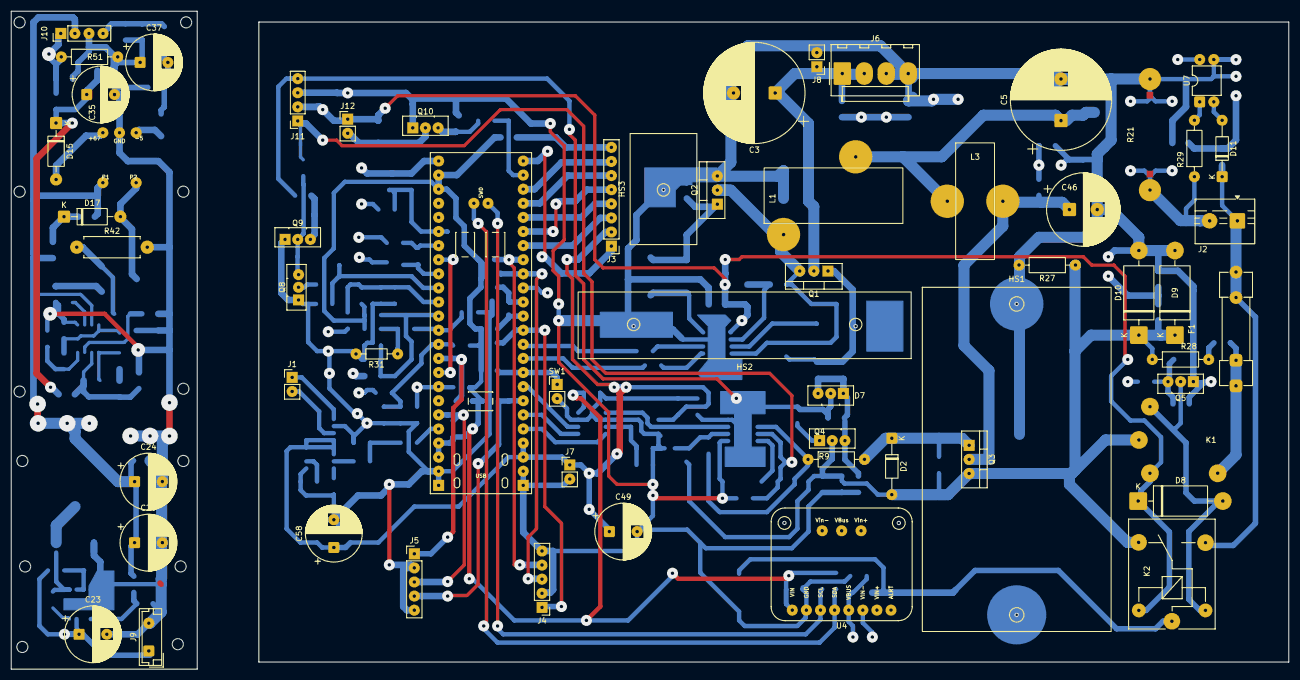
[picture p13: board POWER_0-50.kicad_pcb from above]

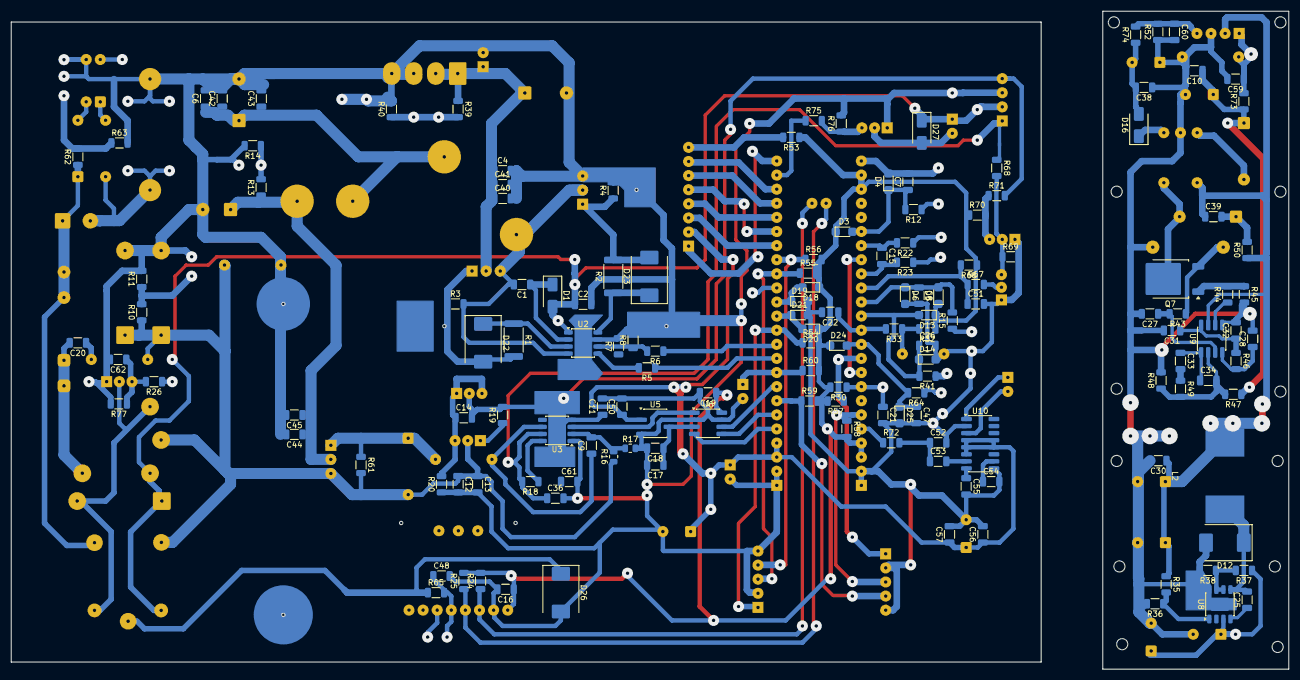
[picture p14: board POWER_0-50.kicad_pcb from below]

Board: 2 copper layers, 230.1 x 118.5 mm, 207 parts (148 on the bottom side), 106 nets.

Other parts of the board:
HS1: Heatsink_Amp_62x40x34
HS2: Heatsink_Profile_60mm
HS3: Heatsink_Profile_20mm
