Aleksei327/STM32G474-Precision-Lab-Power-Supply/(commit log)

2026-07-20 Add Russian and English KiCad schematic exports
2026-08-06 Publish KiCad sources, PCB documentation and 3D renders
    - add hardware/: KiCad 10 project (schematic, layout, project footprint
    library), 16 hand-written VRML models with the Python generators that
    produce them, the SKiDL netlist generator and the wire-jumper list
    - add docs/pcb.md and docs/pcb.ru.md: the two boards, the single-sided
    plus wire-jumper approach, and the home-etching drill/pad conventions
    - add five 3D renders and the copper layout plot with the jumper layer
    - refresh both schematic SVG exports to the current revision
    - update development status and thermal figures in both READMEs
2026-08-06 Add CC BY-NC-ND 4.0 license and terms of use
    Documentation, schematic and hardware design files are published under
    CC BY-NC-ND 4.0, with an explicit additional permission to build a single
    unit for private non-commercial use. Selling boards, kits or assembled
    units, and publishing modified versions, require written permission.
    NOTICE.md states the terms in English and Russian, records that the
    firmware is deliberately not published, and adds author contact details.
2026-11-10 Update status: boards assembled and in bring-up, add bench photos and first measurements
